mschatz3/ECE-490-1-Capstone/Battery Enclosure v6.3mf

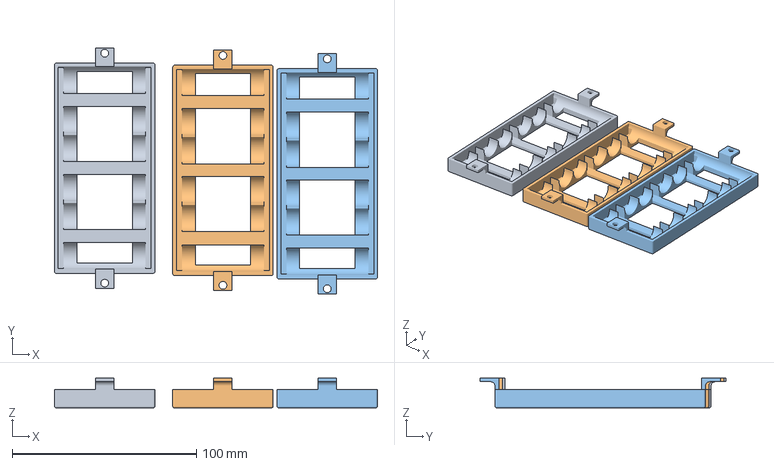
[picture p1: CAD file, 2025-03-27]
Battery Enclosure v6.3mf
175.3 x 133.5 x 16.2 mm
Battery Enclosure v6 x 3
