mschatz3/ECE-490-1-Capstone/PDU/PDU.step

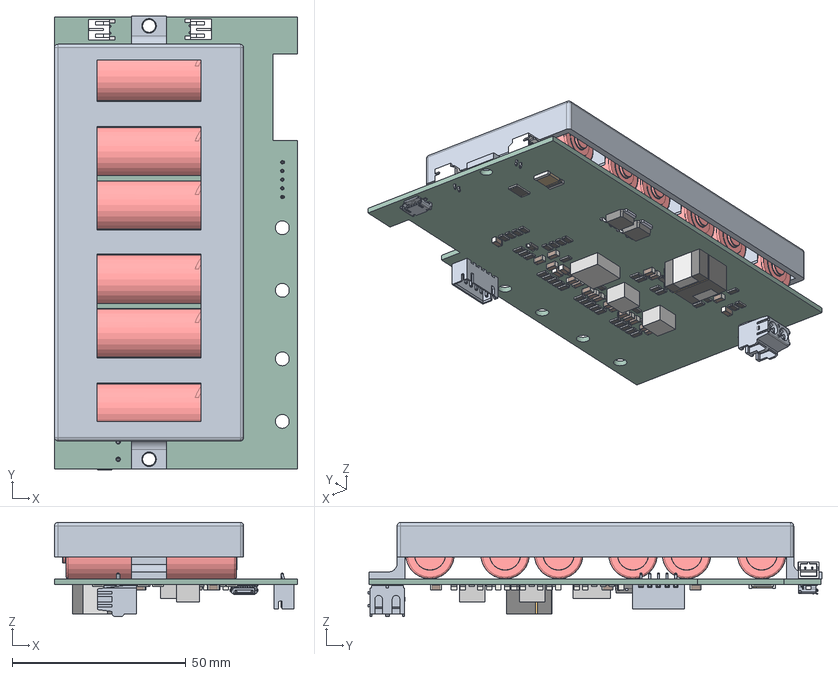
[picture p2: CAD file, 2025-03-27]
PDU/PDU.step
70.0 x 130.7 x 27.1 mm
Enclosure w Bat v1
S2B-PH-K-S x 2
R_1206_3216Metric x 41
C_1206_3216Metric x 25
(Unsaved) x 3
DRL6 x 3
R_2512_6332Metric
D_1206
B5B-XH-A
DDC0006A_ASM
IRLR2705TRPBF x 2
PDU_PCB
