mschatz3/ECE-490-1-Capstone/Capstone_DataLogger/Capstone Assembly Bottom v2.png

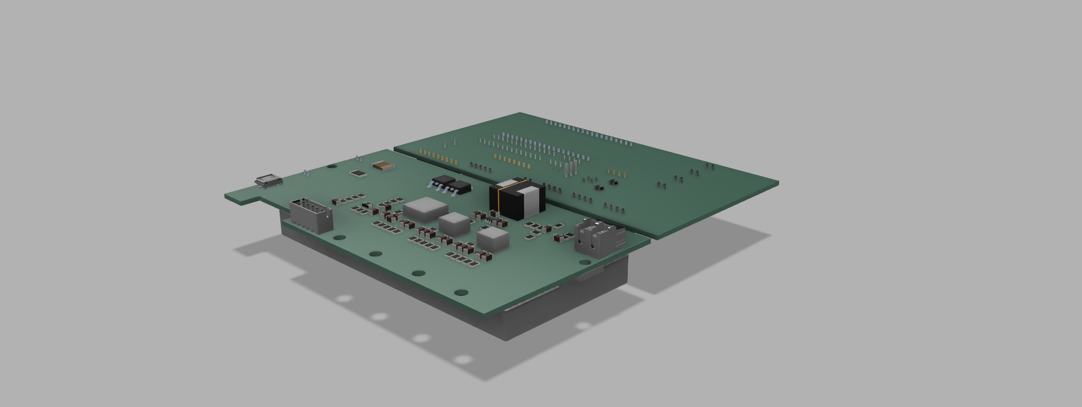
Capstone_DataLogger/Capstone Assembly Bottom v2.png
