mschatz3/ECE-490-1-Capstone/Capstone_DataLogger/Capstone_DataLogger.kicad_pcb

## KiCad design Capstone_DataLogger/Capstone_DataLogger.kicad_pcb (2025-03-27)

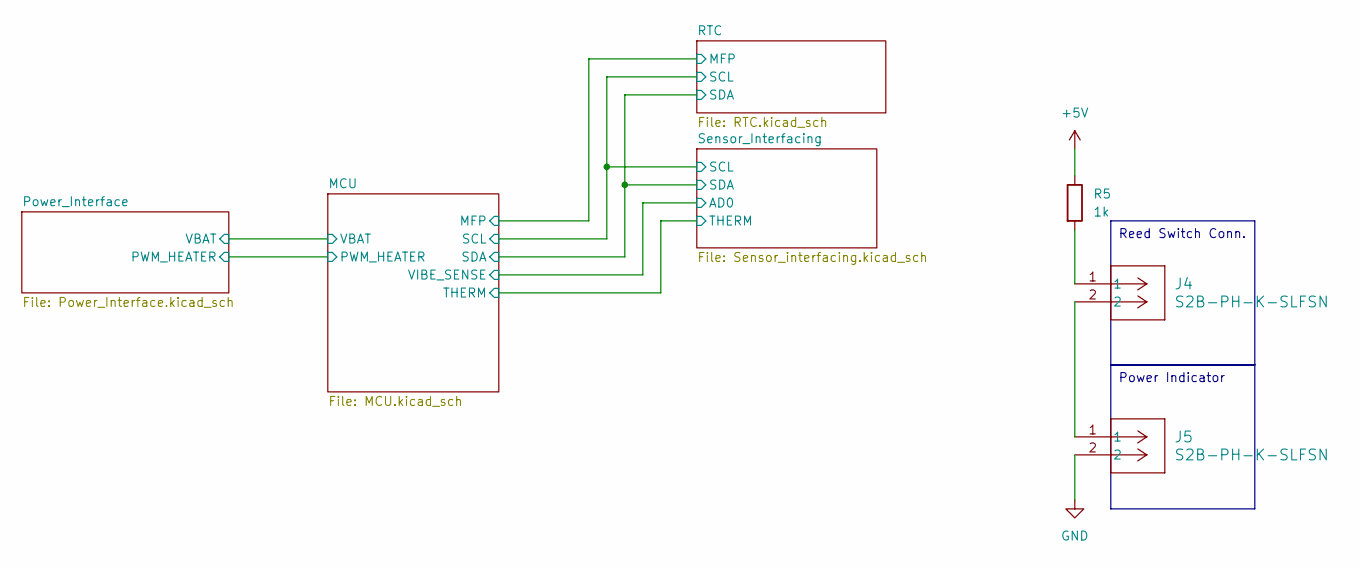
[picture p5: schematic Capstone_DataLogger.kicad_sch, Capstone Data Logger]

Parts:
J4, J5: S2B-PH-K-SLFSN; CONN_B2B-XH-A_JST
R5: 1k; R_1206_3216Metric_Pad1.30x1.75mm_HandSolder

Connections:
+5V: R5.1; also elsewhere on the board
GND: J5.2; also elsewhere on the board
unnamed: J4.1, R5.2
unnamed: J4.2, J5.1

Notes on the sheet:
Power Indicator
Reed Switch Conn.

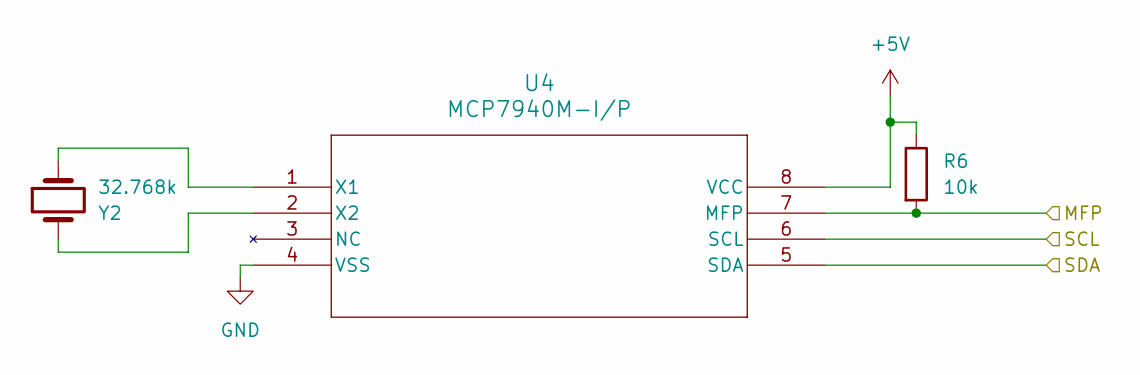
[picture p6: schematic RTC.kicad_sch, Real Time Clock]

Parts:
R6: 10k; R_1206_3216Metric_Pad1.30x1.75mm_HandSolder
U4: MCP7940M-I/P; PDIP8_300MC_MCH
Y2: 32.768k; Cylindrical Can, Radial

Connections:
+5V: R6.1, U4.8 (VCC); also elsewhere on the board
/MCU/MFP: R6.2, U4.7 (MFP); also elsewhere on the board
/MCU/SCL: U4.6 (SCL); also elsewhere on the board
/MCU/SDA: U4.5 (SDA); also elsewhere on the board
GND: U4.4 (VSS); also elsewhere on the board
unnamed: U4.1 (X1), Y2.1
unnamed: U4.2 (X2), Y2.2

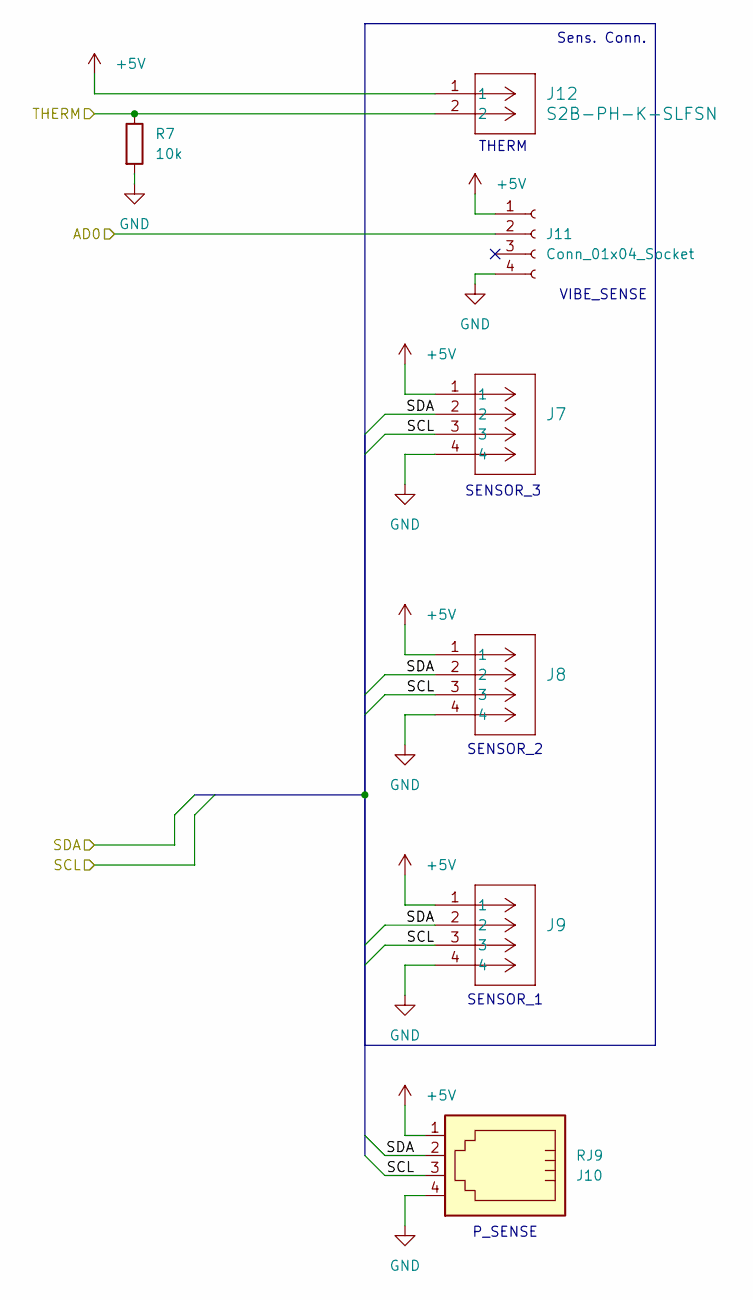
[picture p7: schematic Sensor_interfacing.kicad_sch, Sensor Connectors]

Parts:
J7, J8, J9: S4B-PH-K-SLFSN; CONN_B4B-XH-A_JST
J10: RJ9
J11: Conn_01x04_Socket; PinSocket_1x04_P2.54mm_Horizontal
J12: S2B-PH-K-SLFSN; CONN_B2B-XH-A_JST
R7: 10k; R_1206_3216Metric_Pad1.30x1.75mm_HandSolder

Connections:
+5V: J7.1, J8.1, J9.1, J10.1, J11.1, J12.1; also elsewhere on the board
/MCU/SCL: J7.3, J8.3, J9.3, J10.3; also elsewhere on the board
/MCU/SDA: J7.2, J8.2, J9.2, J10.2; also elsewhere on the board
/MCU/THERM: J12.2, R7.1; also elsewhere on the board
/MCU/VIBE_SENSE: J11.2; also elsewhere on the board
GND: J7.4, J8.4, J9.4, J10.4, J11.4, R7.2; also elsewhere on the board

Notes on the sheet:
Sens. Conn.
P_SENSE
SENSOR_2
SENSOR_1
VIBE_SENSE
THERM
SENSOR_3

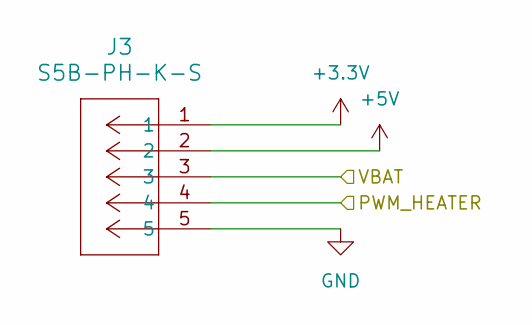
[picture p8: schematic Power_Interface.kicad_sch, Power Interface]

Parts:
J3: S5B-PH-K-S; CONN_B5B-XH-A_JST

Connections:
+3.3V: J3.1; also elsewhere on the board
+5V: J3.2; also elsewhere on the board
/MCU/PWM_HEATER: J3.4; also elsewhere on the board
/MCU/VBAT: J3.3; also elsewhere on the board
GND: J3.5; also elsewhere on the board

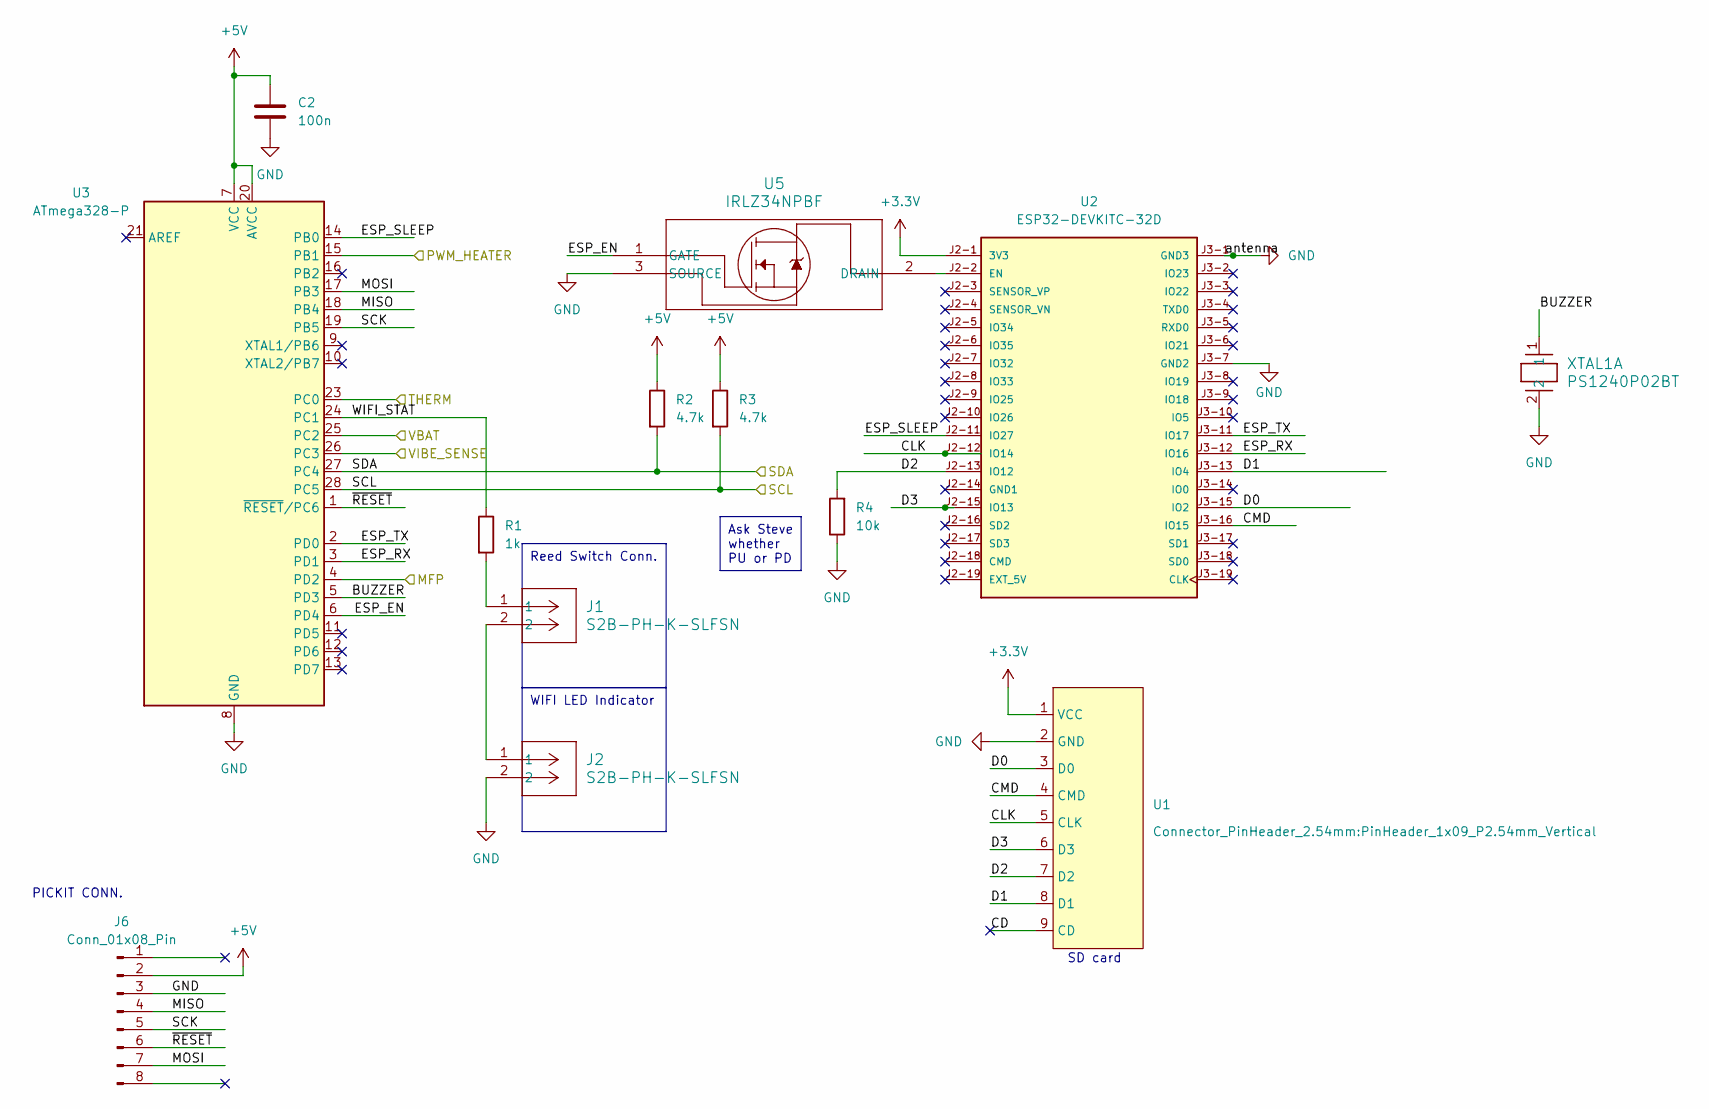
[picture p9: schematic MCU.kicad_sch, Capstone]

Parts:
C2: 100n; C_1206_3216Metric_Pad1.33x1.80mm_HandSolder
J1, J2: S2B-PH-K-SLFSN; CONN_B2B-XH-A_JST
J6: Conn_01x08_Pin; PinHeader_1x08_P2.54mm_Vertical
R1: 1k; R_1206_3216Metric_Pad1.30x1.75mm_HandSolder
R2, R3: 4.7k; R_1206_3216Metric_Pad1.30x1.75mm_HandSolder
R4: 10k; R_1206_3216Metric_Pad1.30x1.75mm_HandSolder
U1: PinHeader_1x09_P2.54mm_Vertical
U2: ESP32-DEVKITC-32D; MODULE_ESP32-DEVKITC-32D; PARTREV V4
U3: ATmega328-P; DIP-28_W7.62mm
U5: IRLZ34NPBF; TO-220AB_INF
XTAL1: PS1240P02BT; XTAL_PS1240P02BT_TDK

Connections:
+3.3V: U1.1 (VCC), U2.J2-1 (3V3); also elsewhere on the board
+5V: C2.1, J6.2, R2.1, R3.1, U3.7 (VCC), U3.20 (AVCC); also elsewhere on the board
/MCU/BUZZER: U3.5 (PD3), XTAL1.1
/MCU/CD: U1.9 (CD)
/MCU/CLK: U1.5 (CLK), U2.J2-12 (IO14)
/MCU/CMD: U1.4 (CMD), U2.J3-16 (IO15)
/MCU/D0: U1.3 (D0), U2.J3-15 (IO2)
/MCU/D1: U1.8 (D1), U2.J3-13 (IO4)
/MCU/D2: R4.2, U1.7 (D2), U2.J2-13 (IO12)
/MCU/D3: U1.6 (D3), U2.J2-15 (IO13)
/MCU/ESP_EN: U3.6 (PD4), U5.1 (GATE)
/MCU/ESP_RX: U2.J3-12 (IO16), U3.3 (PD1)
/MCU/ESP_SLEEP: U2.J2-11 (IO27), U3.14 (PB0)
/MCU/ESP_TX: U2.J3-11 (IO17), U3.2 (PD0)
/MCU/MFP: U3.4 (PD2); also elsewhere on the board
/MCU/MISO: J6.4, U3.18 (PB4)
/MCU/MOSI: J6.7, U3.17 (PB3)
/MCU/PWM_HEATER: U3.15 (PB1); also elsewhere on the board
/MCU/SCK: J6.5, U3.19 (PB5)
/MCU/SCL: R3.2, U3.28 (PC5); also elsewhere on the board
/MCU/SDA: R2.2, U3.27 (PC4); also elsewhere on the board
/MCU/THERM: U3.23 (PC0); also elsewhere on the board
/MCU/VBAT: U3.25 (PC2); also elsewhere on the board
/MCU/VIBE_SENSE: U3.26 (PC3); also elsewhere on the board
/MCU/WIFI_STAT: R1.1, U3.24 (PC1)
/MCU/~RESET: J6.6, U3.1 (~RESET/PC6)
GND: C2.2, J2.2, J6.3, R4.1, U1.2 (GND), U2.J3-1 (GND3), U2.J3-7 (GND2), U3.8 (GND), U3.22 (GND), U5.3 (SOURCE), XTAL1.2; also elsewhere on the board
unnamed: J1.1, R1.2
unnamed: J1.2, J2.1
unnamed: U2.J2-2 (EN), U5.2 (DRAIN)

Notes on the sheet:
Reed Switch Conn.
WIFI LED Indicator
Ask Steve whether PU or PD
PICKIT CONN.
SD card

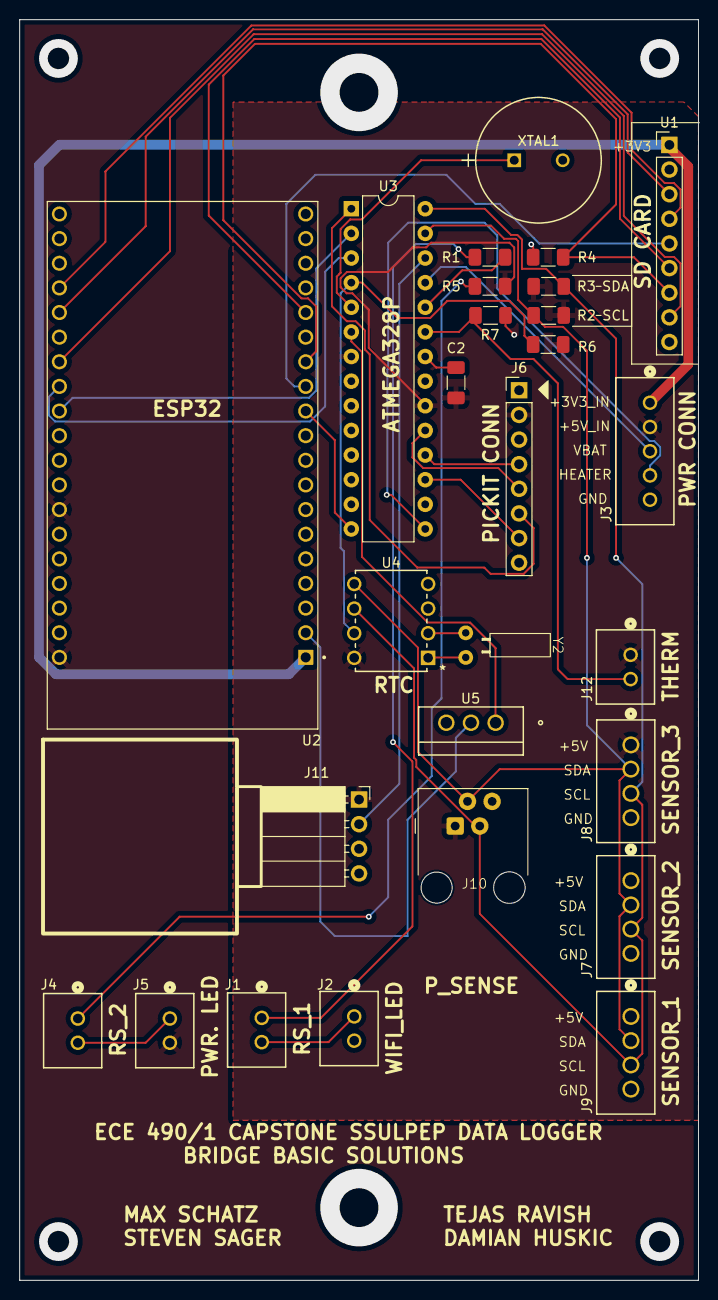
[picture p10: board Capstone_DataLogger.kicad_pcb from above]

Board: 2 copper layers, 70.0 x 130.0 mm, 27 parts (0 on the bottom side), 33 nets.
