mschatz3/ECE-490-1-Capstone/PDU/PDU.kicad_pcb

## KiCad design PDU/PDU.kicad_pcb (2025-03-27)

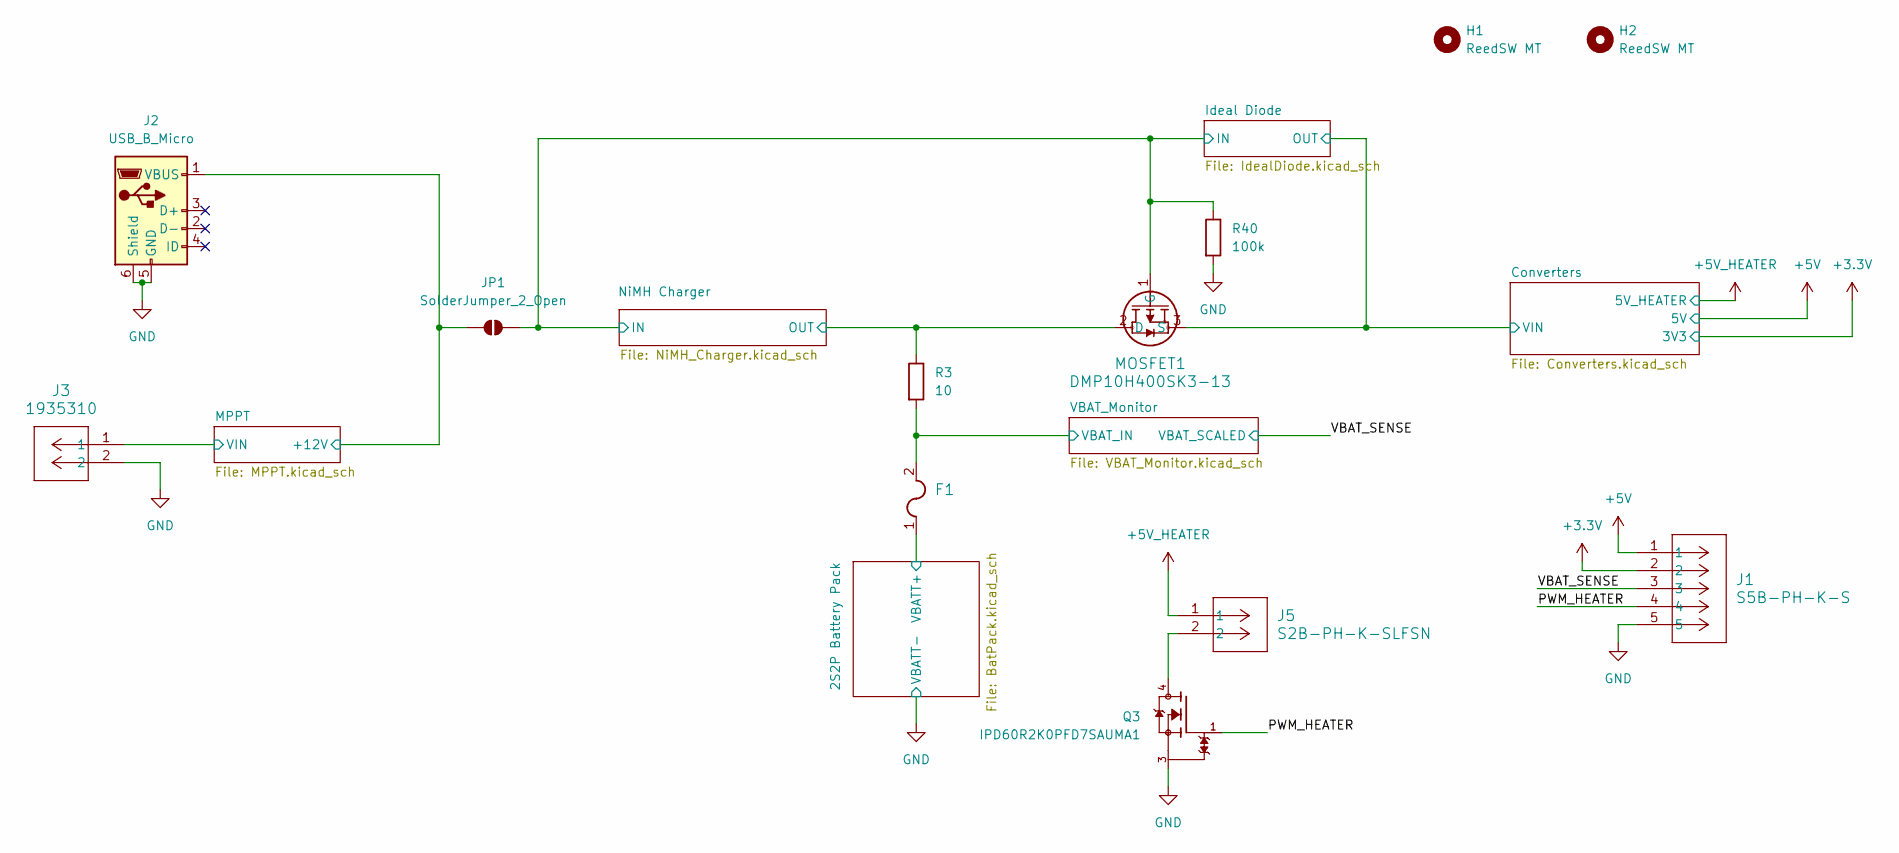
[picture p11: schematic PDU.kicad_sch]

Parts:
F1: 39212000000; Fuse_2920_7451Metric_Pad2.10x5.45mm_HandSolder
H1, H2: ReedSW MT; ReedSW
J1: S5B-PH-K-S; CONN_B5B-XH-A_JST
J2: USB_B_Micro; USB_Micro-B_Amphenol_10104110_Horizontal
J3: 1935310; CONN_1935310_PXC
J5: S2B-PH-K-SLFSN; CONN_S2B-PH-K-S_JST
JP1: SolderJumper_2_Open; SolderJumper-2_P1.3mm_Open_TrianglePad1.0x1.5mm
MOSFET1: DMP10H400SK3-13; TO252-DPAK-DMP10H400SK3_DIO
Q3: IPD60R2K0PFD7SAUMA1; DPAK229P994X240-3N; PARTREV 02
R3: 10; R_2512_6332Metric_Pad1.40x3.35mm_HandSolder
R40: 100k; R_1206_3216Metric_Pad1.30x1.75mm_HandSolder

Connections:
+3.3V: J1.2; also elsewhere on the board
+5V: J1.1; also elsewhere on the board
+5V_HEATER: J5.1; also elsewhere on the board
/2S2P Battery Pack/VBATT+: F1.1; also elsewhere on the board
/Converters/VIN: MOSFET1.3 (S); also elsewhere on the board
/Ideal Diode/IN: JP1.2 (B), MOSFET1.1 (G), R40.1; also elsewhere on the board
/MPPT/+12V: J2.1 (VBUS), JP1.1 (A); also elsewhere on the board
/MPPT/VIN: J3.1; also elsewhere on the board
/NiMH Charger/OUT: MOSFET1.2 (D), R3.1; also elsewhere on the board
/PWM_HEATER: J1.4, Q3.1
/VBAT_Monitor/VBAT_IN: F1.2, R3.2; also elsewhere on the board
/VBAT_SENSE: J1.3; also elsewhere on the board
GND: J1.5, J2.5 (GND), J2.6 (Shield), J3.2, Q3.3, R40.2; also elsewhere on the board
unnamed: J5.2, Q3.4

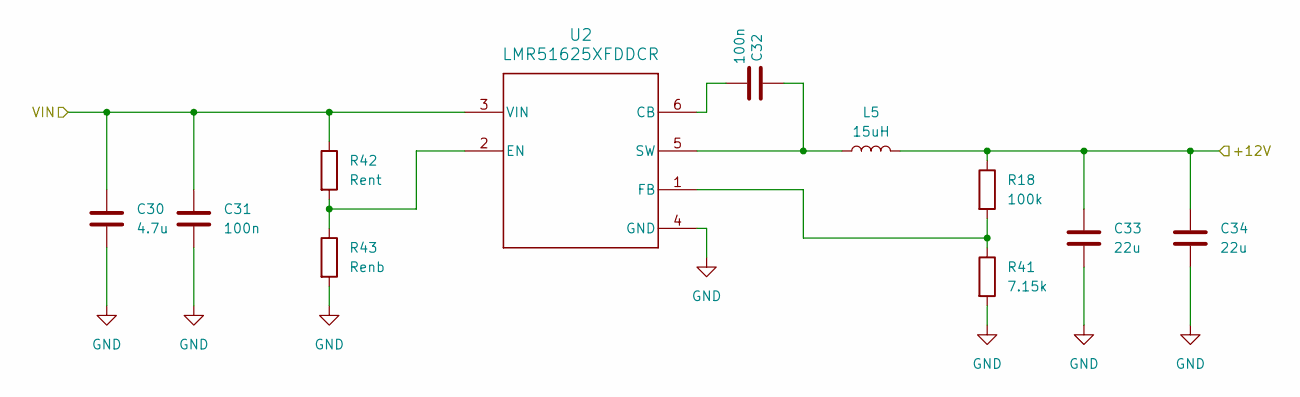
[picture p12: schematic MPPT.kicad_sch]

Parts:
C30: 4.7u; C_1206_3216Metric_Pad1.33x1.80mm_HandSolder
C31, C32: 100n; C_1206_3216Metric_Pad1.33x1.80mm_HandSolder
C33, C34: 22u; C_1206_3216Metric_Pad1.33x1.80mm_HandSolder
L5: 15uH; IND_BOURNS_SRR1208
R18: 100k; R_1206_3216Metric_Pad1.30x1.75mm_HandSolder
R41: 7.15k; R_1206_3216Metric_Pad1.30x1.75mm_HandSolder
R42: Rent; R_1206_3216Metric_Pad1.30x1.75mm_HandSolder
R43: Renb; R_1206_3216Metric_Pad1.30x1.75mm_HandSolder
U2: LMR51625XFDDCR; DDC0006A-MFG

Connections:
/MPPT/+12V: C33.1, C34.1, L5.2, R18.1; also elsewhere on the board
/MPPT/VIN: C30.1, C31.1, R42.1, U2.3 (VIN); also elsewhere on the board
GND: C30.2, C31.2, C33.2, C34.2, R41.2, R43.2, U2.4 (GND); also elsewhere on the board
unnamed: C32.2, U2.6 (CB)
unnamed: R42.2, R43.1, U2.2 (EN)
unnamed: R18.2, R41.1, U2.1 (FB)
unnamed: C32.1, L5.1, U2.5 (SW)

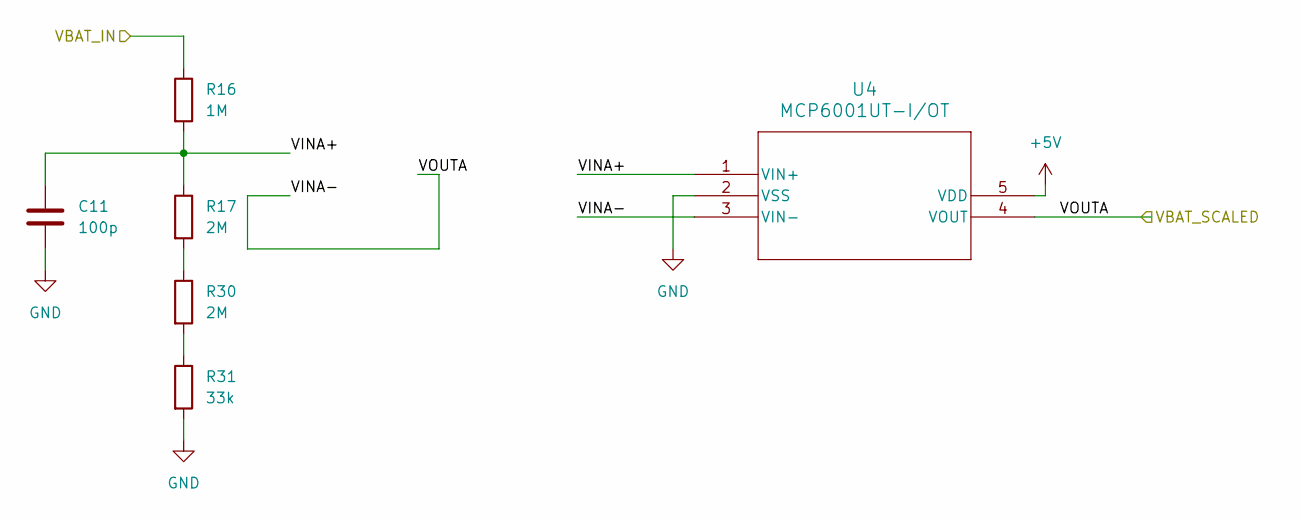
[picture p13: schematic VBAT_Monitor.kicad_sch, Battery Monitor]

Parts:
C11: 100p; C_1206_3216Metric_Pad1.33x1.80mm_HandSolder
R16: 1M; R_1206_3216Metric_Pad1.30x1.75mm_HandSolder
R17, R30: 2M; R_1206_3216Metric_Pad1.30x1.75mm_HandSolder
R31: 33k; R_1206_3216Metric_Pad1.30x1.75mm_HandSolder
U4: MCP6001UT-I/OT; SOT-23-5_MC_MCH

Connections:
+5V: U4.5 (VDD); also elsewhere on the board
/VBAT_Monitor/VBAT_IN: R16.1; also elsewhere on the board
/VBAT_Monitor/VINA+: C11.1, R16.2, R17.1, U4.1 (VIN+)
/VBAT_SENSE: U4.3 (VIN-), U4.4 (VOUT); also elsewhere on the board
GND: C11.2, R31.2, U4.2 (VSS); also elsewhere on the board
unnamed: R17.2, R30.1
unnamed: R30.2, R31.1

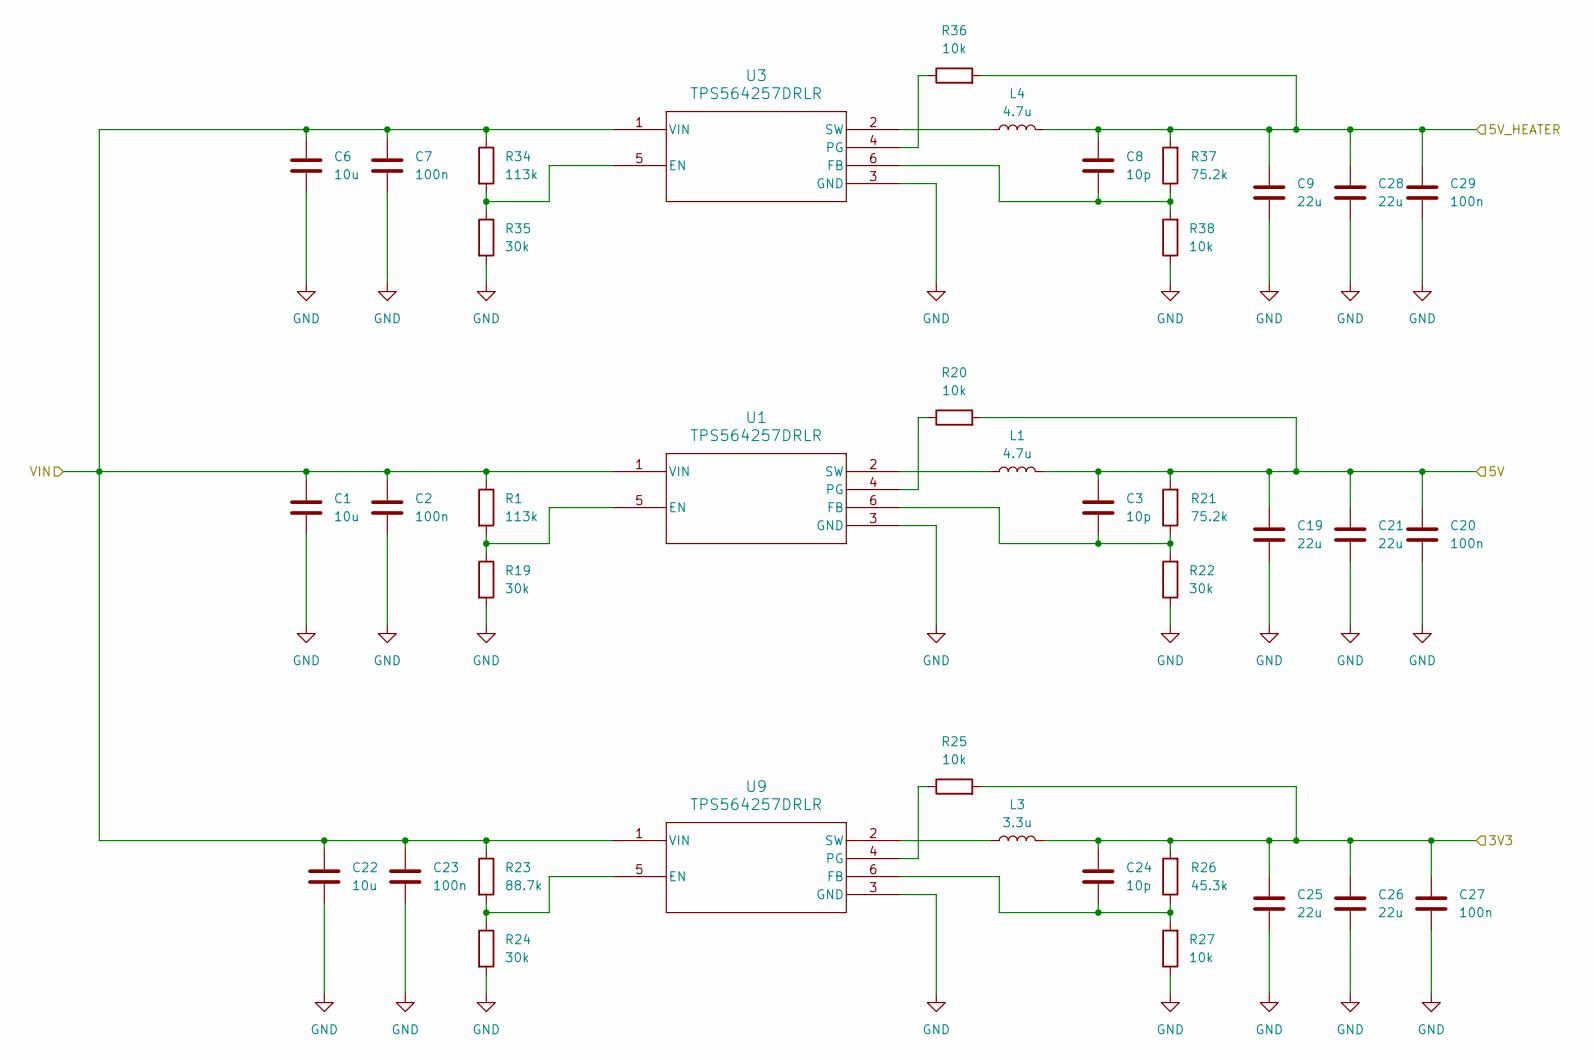
[picture p14: schematic Converters.kicad_sch]

Parts:
C1, C6, C22: 10u; C_1206_3216Metric_Pad1.33x1.80mm_HandSolder
C2, C7, C20, C23, C29: 100n; C_1206_3216Metric_Pad1.33x1.80mm_HandSolder
C3, C8: 10p; R_1206_3216Metric_Pad1.30x1.75mm_HandSolder
C9, C19, C21, C25, C26, C28: 22u; C_1206_3216Metric_Pad1.33x1.80mm_HandSolder
C24: 10p; C_1206_3216Metric_Pad1.33x1.80mm_HandSolder
C27: 100n; R_1206_3216Metric_Pad1.30x1.75mm_HandSolder
L1, L4: 4.7u; L_Bourns_SRP7028A_7.3x6.6mm
L3: 3.3u; IND_IHLP-4040DZ_VIS
R1, R34: 113k; R_1206_3216Metric_Pad1.30x1.75mm_HandSolder
R19, R22, R24, R35: 30k; R_1206_3216Metric_Pad1.30x1.75mm_HandSolder
R20, R25, R27, R36, R38: 10k; R_1206_3216Metric_Pad1.30x1.75mm_HandSolder
R21, R37: 75.2k; R_1206_3216Metric_Pad1.30x1.75mm_HandSolder
R23: 88.7k; R_1206_3216Metric_Pad1.30x1.75mm_HandSolder
R26: 45.3k; R_1206_3216Metric_Pad1.30x1.75mm_HandSolder
U1, U3, U9: TPS564257DRLR; TPS564242DRLR_TEX

Connections:
+3.3V: C24.1, C25.1, C26.1, C27.1, L3.2, R25.2, R26.2; also elsewhere on the board
+5V: C3.1, C19.1, C20.1, C21.1, L1.2, R20.2, R21.2; also elsewhere on the board
+5V_HEATER: C8.1, C9.1, C28.1, C29.1, L4.2, R36.2, R37.2; also elsewhere on the board
/Converters/VIN: C1.1, C2.1, C6.1, C7.1, C22.1, C23.1, R1.1, R23.1, R34.1, U1.1 (VIN), U3.1 (VIN), U9.1 (VIN); also elsewhere on the board
GND: C1.2, C2.2, C6.2, C7.2, C9.2, C19.2, C20.2, C21.2, C22.2, C23.2, C25.2, C26.2, C27.2, C28.2, C29.2, R19.2, R22.1, R24.2, R27.1, R35.2, R38.1, U1.3 (GND), U3.3 (GND), U9.3 (GND); also elsewhere on the board
unnamed: R1.2, R19.1, U1.5 (EN)
unnamed: C3.2, R21.1, R22.2, U1.6 (FB)
unnamed: R20.1, U1.4 (PG)
unnamed: L1.1, U1.2 (SW)
unnamed: R34.2, R35.1, U3.5 (EN)
unnamed: C8.2, R37.1, R38.2, U3.6 (FB)
unnamed: R36.1, U3.4 (PG)
unnamed: L4.1, U3.2 (SW)
unnamed: R23.2, R24.1, U9.5 (EN)
unnamed: C24.2, R26.1, R27.2, U9.6 (FB)
unnamed: R25.1, U9.4 (PG)
unnamed: L3.1, U9.2 (SW)

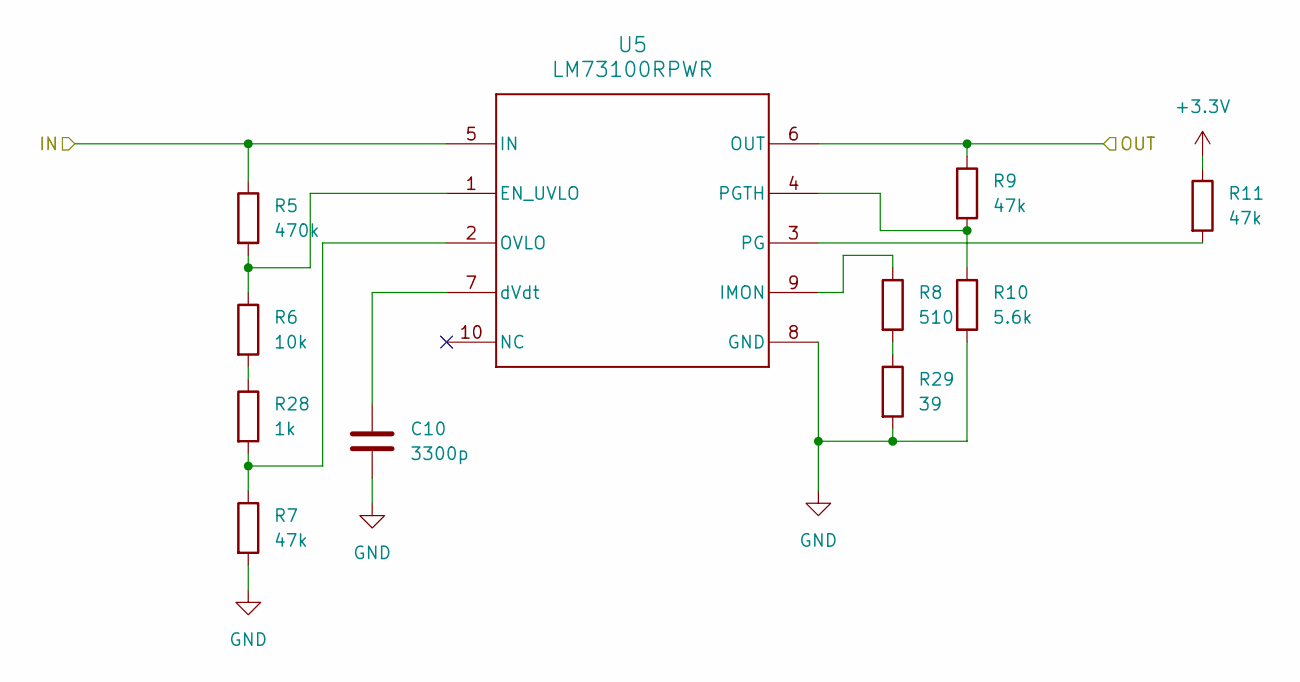
[picture p15: schematic IdealDiode.kicad_sch, Ideal Diode]

Parts:
C10: 3300p; C_1206_3216Metric_Pad1.33x1.80mm_HandSolder
R5: 470k; R_1206_3216Metric_Pad1.30x1.75mm_HandSolder
R6: 10k; C_1206_3216Metric_Pad1.33x1.80mm_HandSolder
R7, R9, R11: 47k; R_1206_3216Metric_Pad1.30x1.75mm_HandSolder
R8: 510; R_1206_3216Metric_Pad1.30x1.75mm_HandSolder
R10: 5.6k; R_1206_3216Metric_Pad1.30x1.75mm_HandSolder
R28: 1k; R_1206_3216Metric_Pad1.30x1.75mm_HandSolder
R29: 39; R_1206_3216Metric_Pad1.30x1.75mm_HandSolder
U5: LM73100RPWR; RPW0010A-MFG

Connections:
+3.3V: R11.1; also elsewhere on the board
/Converters/VIN: R9.1, U5.6 (OUT); also elsewhere on the board
/Ideal Diode/IN: R5.1, U5.5 (IN); also elsewhere on the board
GND: C10.2, R7.2, R10.2, R29.2, U5.8 (GND); also elsewhere on the board
unnamed: R6.2, R28.1
unnamed: R8.2, R29.1
unnamed: R5.2, R6.1, U5.1 (EN_UVLO)
unnamed: R8.1, U5.9 (IMON)
unnamed: R7.1, R28.2, U5.2 (OVLO)
unnamed: R11.2, U5.3 (PG)
unnamed: R9.2, R10.1, U5.4 (PGTH)
unnamed: C10.1, U5.7 (dVdt)

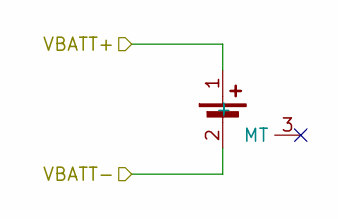
[picture p16: schematic BatPack.kicad_sch, 2S2P Battery Config]

Parts:
M1: AA_Bat_Contact

Connections:
/2S2P Battery Pack/VBATT+: M1.1 (+); also elsewhere on the board
GND: M1.2 (-); also elsewhere on the board

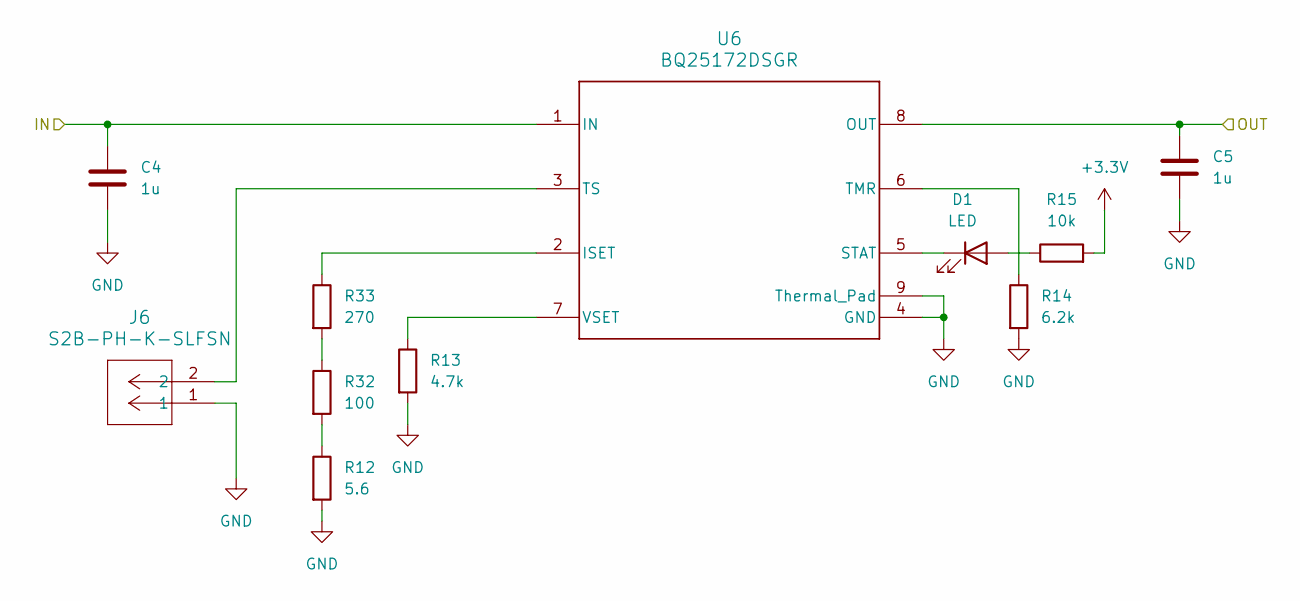
[picture p17: schematic NiMH_Charger.kicad_sch, NiMH Charger Control]

Parts:
C4, C5: 1u; C_1206_3216Metric_Pad1.33x1.80mm_HandSolder
D1: LED; D_1206_3216Metric_Pad1.42x1.75mm_HandSolder
J6: S2B-PH-K-SLFSN; CONN_S2B-PH-K-S_JST
R12: 5.6; R_1206_3216Metric_Pad1.30x1.75mm_HandSolder
R13: 4.7k; R_1206_3216Metric_Pad1.30x1.75mm_HandSolder
R14: 6.2k; R_1206_3216Metric_Pad1.30x1.75mm_HandSolder
R15: 10k; R_1206_3216Metric_Pad1.30x1.75mm_HandSolder
R32: 100; R_1206_3216Metric_Pad1.30x1.75mm_HandSolder
R33: 270; R_1206_3216Metric_Pad1.30x1.75mm_HandSolder
U6: BQ25172DSGR; DSG0008A-IPC_A

Connections:
+3.3V: R15.2; also elsewhere on the board
/Ideal Diode/IN: C4.1, U6.1 (IN); also elsewhere on the board
/NiMH Charger/OUT: C5.1, U6.8 (OUT); also elsewhere on the board
GND: C4.2, C5.2, J6.1, R12.2, R13.2, R14.2, U6.4 (GND), U6.9 (Thermal_Pad); also elsewhere on the board
unnamed: D1.2 (A), R15.1
unnamed: D1.1 (K), U6.5 (STAT)
unnamed: R12.1, R32.2
unnamed: R32.1, R33.2
unnamed: R33.1, U6.2 (ISET)
unnamed: R14.1, U6.6 (TMR)
unnamed: J6.2, U6.3 (TS)
unnamed: R13.1, U6.7 (VSET)

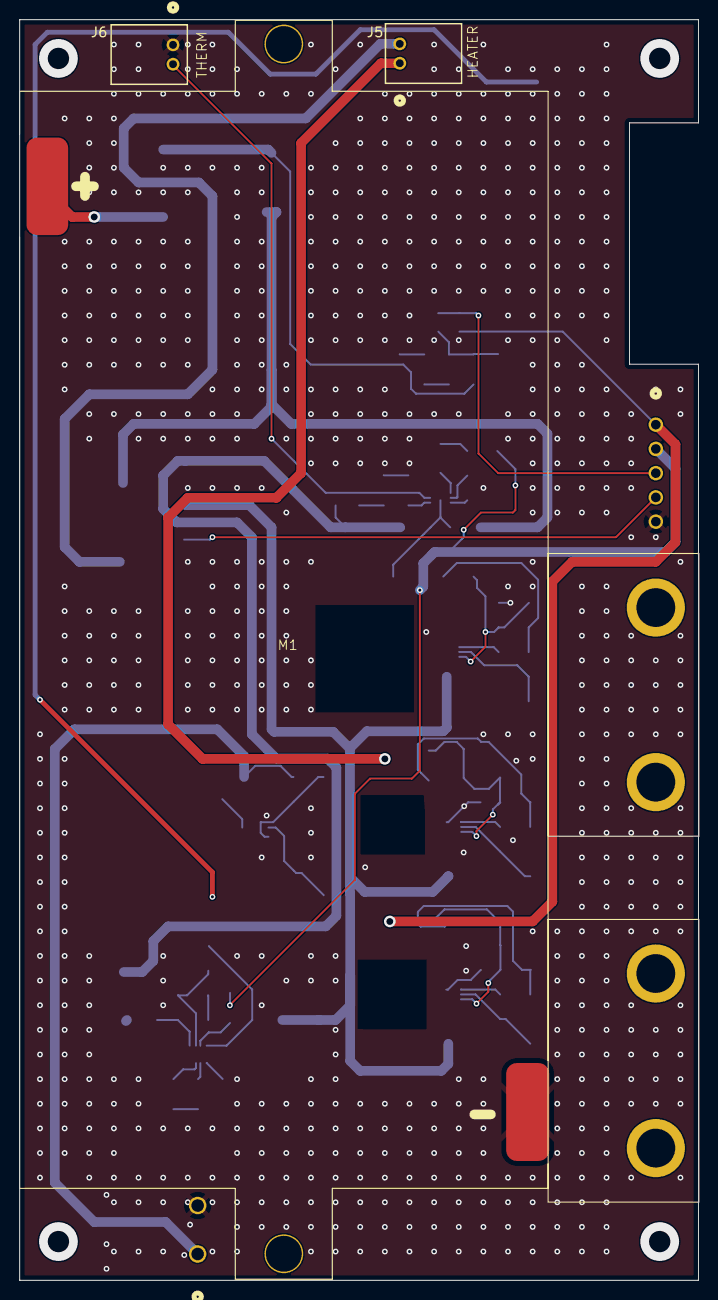
[picture p18: board PDU.kicad_pcb from above]

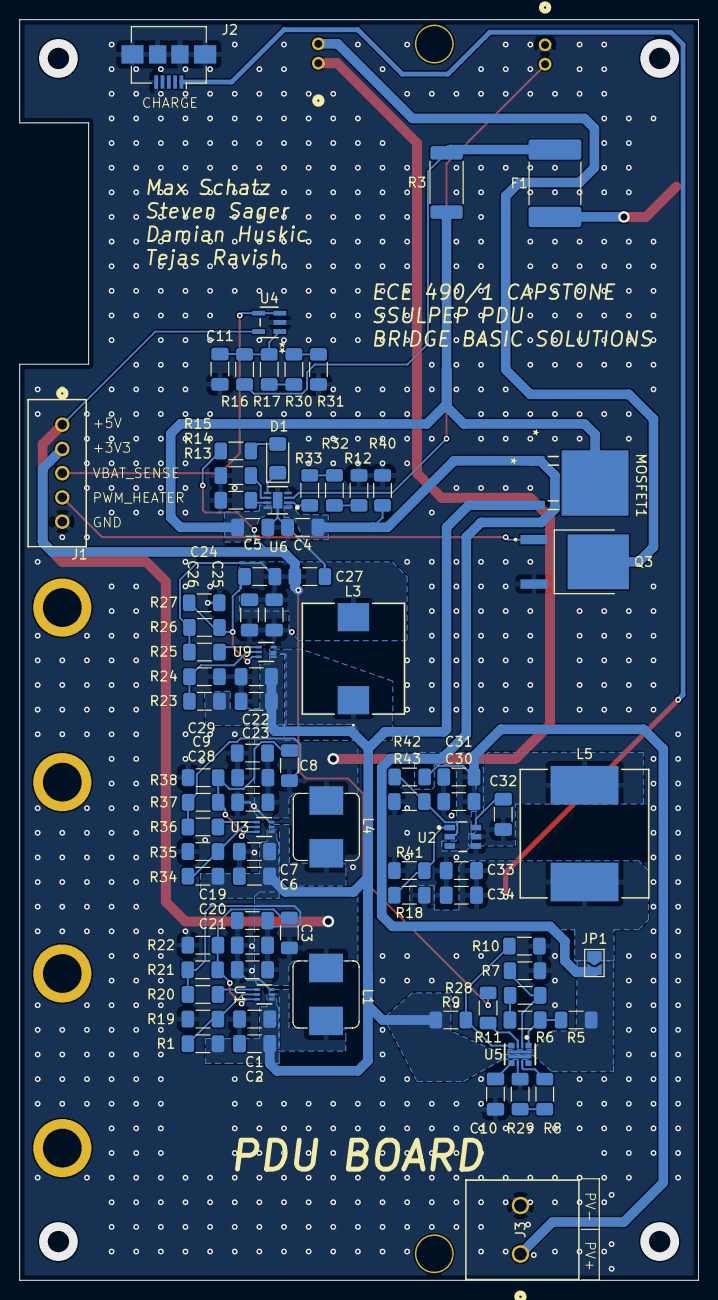
[picture p19: board PDU.kicad_pcb from below]

Board: 2 copper layers, 70.0 x 130.0 mm, 91 parts (86 on the bottom side), 49 nets.
