mschatz3/ECE-490-1-Capstone/ChargerBoard/ChargerBoard.kicad_pcb

## KiCad design ChargerBoard/ChargerBoard.kicad_pcb (2025-01-30)

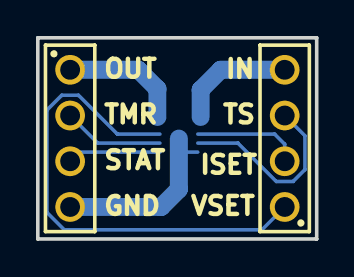
[picture p20: board ChargerBoard.kicad_pcb from above]

Board: 2 copper layers, 15.5 x 11.2 mm, 3 parts (1 on the bottom side), 7 nets.

Parts:
J1, J2: 61300411121
U1: BQ25172DSGR; DSG0008A-IPC_A

Connections:
/GND: J1.4, U1.4 (GND), U1.9 (Thermal_Pad)
/IN: J2.2, J2.4, U1.1 (IN), U1.2 (ISET)
/OUT: J1.1, U1.8 (OUT)
/STAT: J1.3, U1.5 (STAT)
/TMR: J1.2, U1.6 (TMR)
/TS: J2.3, U1.3 (TS)
/VSET: J2.1, U1.7 (VSET)
