mschatz3/ECE-490-1-Capstone/IdealDiodeBoard/IdealDiodeBoard.kicad_pcb

## KiCad design IdealDiodeBoard/IdealDiodeBoard.kicad_pcb (2025-01-30)

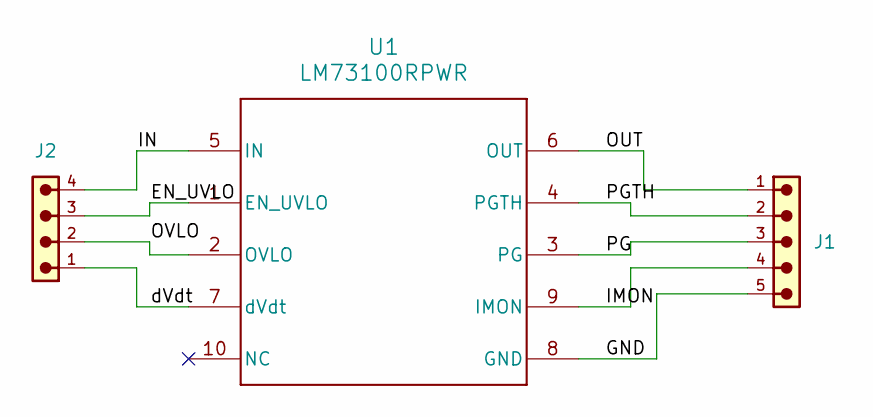
[picture p21: schematic IdealDiodeBoard.kicad_sch]

Parts:
J1: 61300511121; PART-NUMBER 61300511121
J2: 61300411121; PART-NUMBER 61300411121
U1: LM73100RPWR; RPW0010A-MFG

Connections:
/EN_UVLO: J2.3, U1.1 (EN_UVLO)
/GND: J1.5, U1.8 (GND)
/IMON: J1.4, U1.9 (IMON)
/IN: J2.4, U1.5 (IN)
/OUT: J1.1, U1.6 (OUT)
/OVLO: J2.2, U1.2 (OVLO)
/PG: J1.3, U1.3 (PG)
/PGTH: J1.2, U1.4 (PGTH)
/dVdt: J2.1, U1.7 (dVdt)

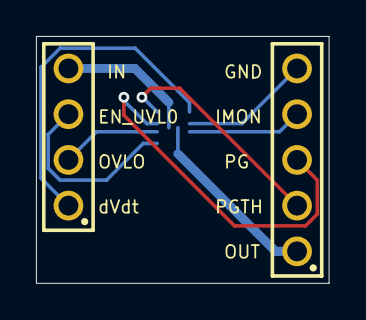
[picture p22: board IdealDiodeBoard.kicad_pcb from above]

Board: 2 copper layers, 16.3 x 13.7 mm, 3 parts (1 on the bottom side), 9 nets.
