mschatz3/ECE-490-1-Capstone/MPPT/MPPT.kicad_pcb

## KiCad design MPPT/MPPT.kicad_pcb (2025-01-30)

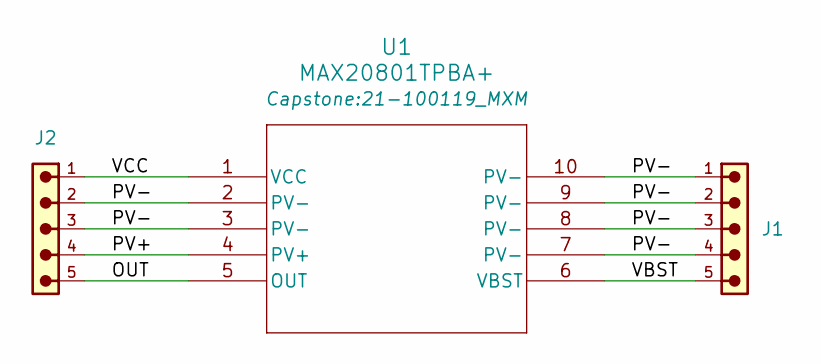
[picture p23: schematic MPPT.kicad_sch]

Parts:
J1, J2: 61300511121; PART-NUMBER 61300511121
U1: MAX20801TPBA+; 21-100119_MXM

Connections:
/OUT: J2.5, U1.5 (OUT)
/PV+: J2.4, U1.4 (PV+)
/PV-: J1.1, J1.2, J1.3, J1.4, J2.2, J2.3, U1.2 (PV-), U1.3 (PV-), U1.7 (PV-), U1.8 (PV-), U1.9 (PV-), U1.10 (PV-)
/VBST: J1.5, U1.6 (VBST)
/VCC: J2.1, U1.1 (VCC)

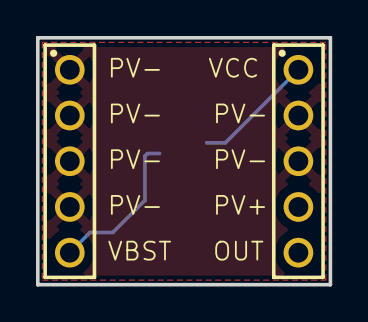
[picture p24: board MPPT.kicad_pcb from above]

Board: 2 copper layers, 16.3 x 13.7 mm, 3 parts (1 on the bottom side), 5 nets.
