mschatz3/ECE-490-1-Capstone/(commit log)

2025-01-30 added resistor
    [Capstone_DataLogger.kicad_sch]
2025-01-31 basic changes
    [Capstone_DataLogger.kicad_pcb, Capstone_DataLogger.kicad_sch, MCU.kicad_sch]
2025-02-06 pcb componet placement changed
    [Capstone_DataLogger.kicad_pcb]
2025-02-11 pcb connected except SD card
    [Capstone_DataLogger.kicad_pcb, Capstone_DataLogger.kicad_sch, MCU.kicad_sch, SD_Card_Reader.kicad_sch]
2025-02-11 pcb connections comeleted
    [Capstone_DataLogger.kicad_pcb, MCU.kicad_sch]
2025-02-13 Revised PCB
    [Capstone_DataLogger.kicad_pcb, Capstone_DataLogger.kicad_sch, MCU.kicad_sch, Power_Interface.kicad_sch, RTC.kicad_sch, Sensor_interfacing.kicad_sch]
2025-02-13 Last revision before oreder
    [Capstone_DataLogger.kicad_pcb, Capstone_DataLogger.kicad_sch, MCU.kicad_sch, Power_Interface.kicad_sch, Sensor_interfacing.kicad_sch]
2025-02-14 NVM another revision before order, should be good now
    [Capstone_DataLogger.kicad_pcb, MCU.kicad_sch]
2025-02-14 Made revision on PDU board before ECLASS submission
    [Capstone_DataLogger-B_Cu.gbr, Capstone_DataLogger-B_Mask.gbr, Capstone_DataLogger-B_Paste.gbr, Capstone_DataLogger-B_Silkscreen.gbr, Capstone_DataLogger-Edge_Cuts.gbr, Capstone_DataLogger-F_Cu.gbr, Capstone_DataLogger-F_Mask.gbr, Capstone_DataLogger-F_Paste.gbr]
2025-03-08 Hypothetical final revision of datalogger
    [Capstone_DataLogger-B_Cu.gbr, Capstone_DataLogger-B_Mask.gbr, Capstone_DataLogger-B_Paste.gbr, Capstone_DataLogger-B_Silkscreen.gbr, Capstone_DataLogger-Edge_Cuts.gbr, Capstone_DataLogger-F_Cu.gbr, Capstone_DataLogger-F_Mask.gbr, Capstone_DataLogger-F_Paste.gbr]
2025-03-27 Last revision
    [BatPack.kicad_sch, Battery Enclosure v6.3mf, Capstone_DataLogger.kicad_pcb, Converters.kicad_sch, MPPT.kicad_sch, NiMH_Charger.kicad_sch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]
